zhjiehua/Network_TemperHumid/README.md

# Network_TemperHumid

网络版温湿度传感器

采集DHT12温湿度数据通过TCP/IP上传.

已实现:
  *tcp client
  *tcp server
  *udp client
  *udp server
