zhjiehua/Network_TemperHumid/PCB/HumNet.PDF

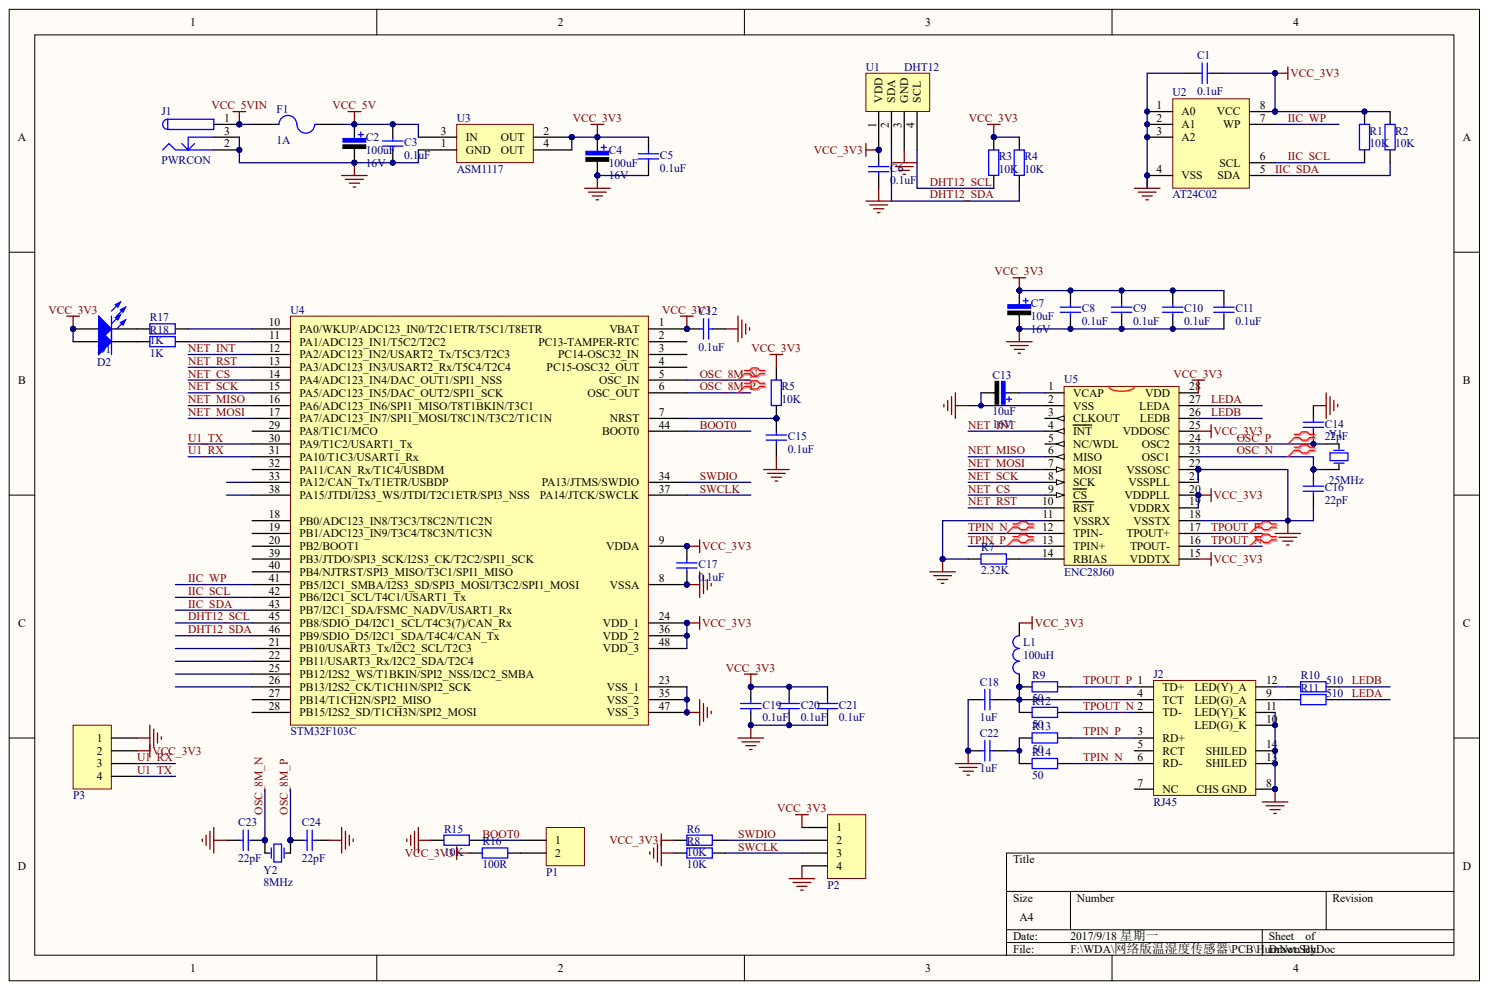
[picture p2: page 1]

U2 | 0.1uF
A0 1
A1 2 | IIC_WP

IIC_SDA

R18 | PA1/ADC123_IN1/T5C2/T2C2 11
1K | PA2/ADC123_IN2/USART2_Tx/T5C3/T2C3 12 PA3/ADC123_IN3/USART2_Rx/T5C4/T2C4 13 PA4/ADC123_IN4/DAC_OUT1/SPI1_NSS 14 PA5/ADC123_IN5/DAC_OUT2/SPI1_SCK 15 PA6/ADC123_IN6/SPI1_MISO/T8T1BKIN/T3C1 16 PA7/ADC123_IN7/SPI1_MOSI/T8C1N/T3C2/T1C1N 17 PA8/T1C1/MCO 29

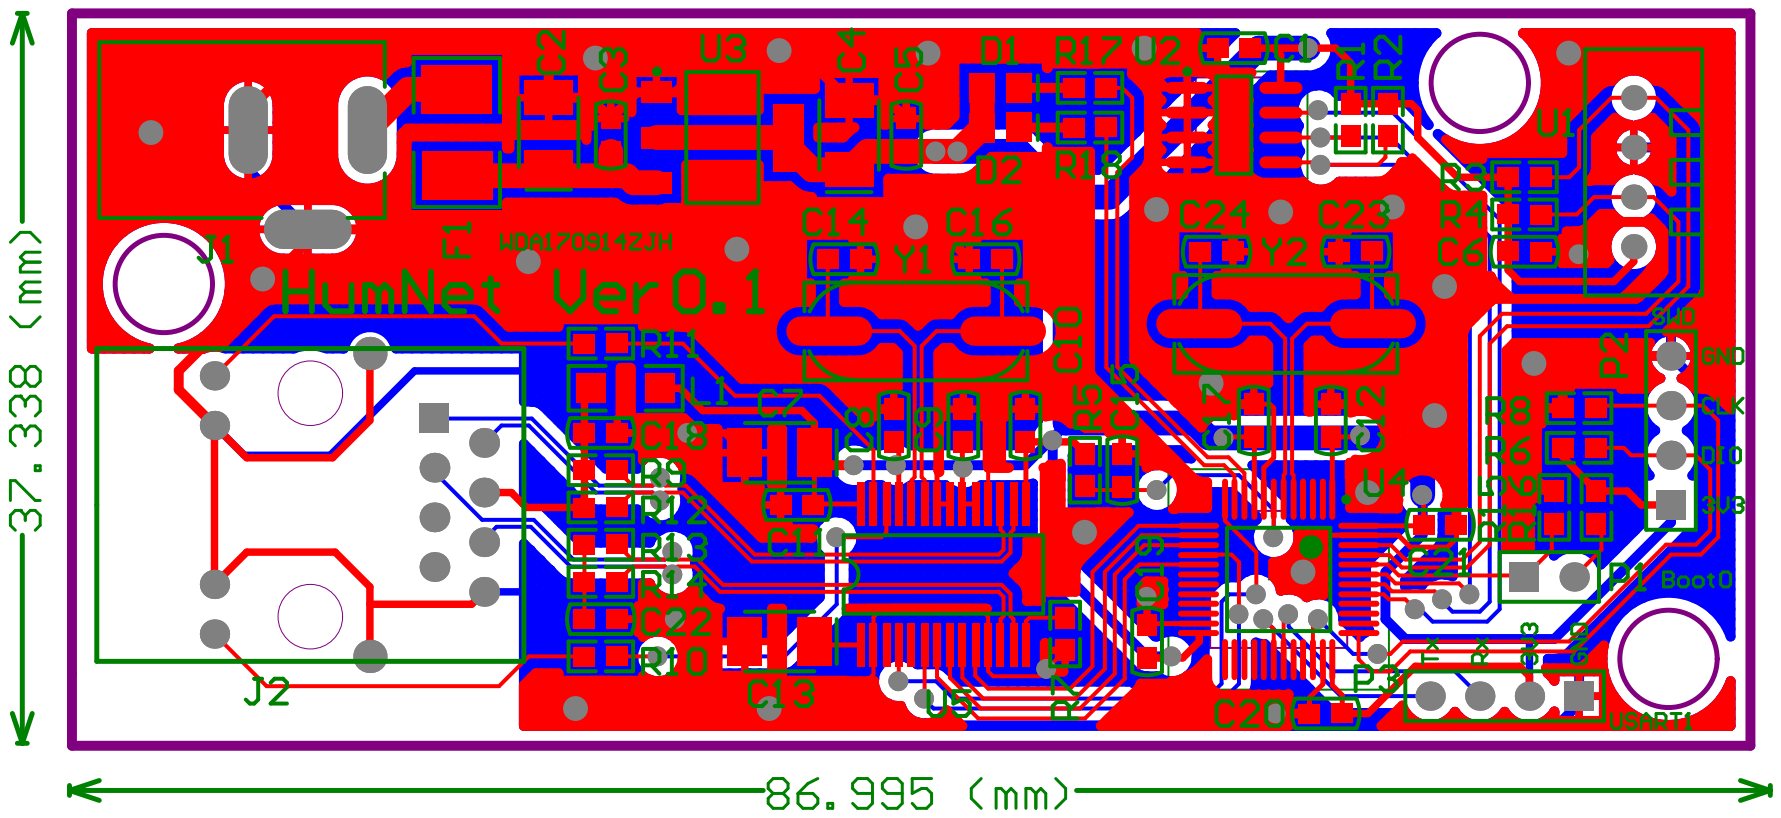
[picture p3: page 2]

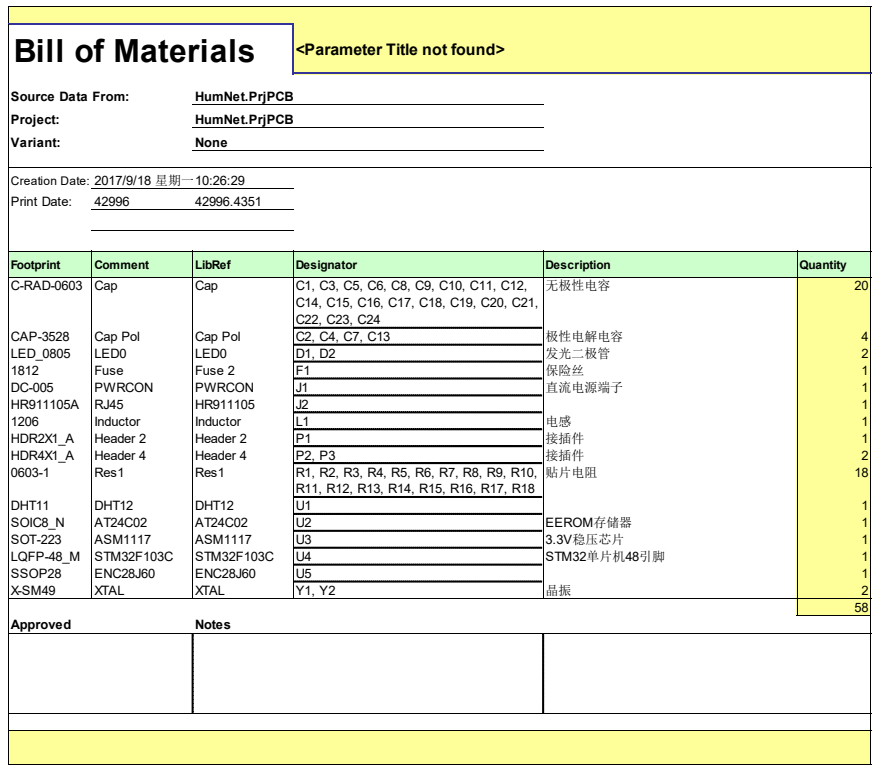
[picture p4: page 3]

Footprint | Comment | LibRef | Designator | Description | Quantity
