zhjiehua/Network_TemperHumid/(list of files, drawings)

Other design files:
PCB/HumNet.PcbDoc
PCB/HumNet.PrjPCB
PCB/HumNet.SchDoc
