zhjiehua/Network_TemperHumid/SRC/HARDWARE/24CXX/myiic.h

#ifndef __MYIIC_H
#define __MYIIC_H
#include "sys.h"
//////////////////////////////////////////////////////////////////////////////////	 
//本程序只供学习使用，未经作者许可，不得用于其它任何用途
//ALIENTEK战舰STM32开发板
//IIC驱动 代码	   
//正点原子@ALIENTEK
//技术论坛:www.openedv.com
//修改日期:2012/9/9
//版本：V1.0
//版权所有，盗版必究。
//Copyright(C) 广州市星翼电子科技有限公司 2009-2019
//All rights reserved									  
//////////////////////////////////////////////////////////////////////////////////

#define DHT12 1

#ifndef DHT12
//IO方向设置
#define SDA_IN()  {GPIOD->CRH&=0XFFFFFF0F;GPIOD->CRH|=(u32)8<<4;}
#define SDA_OUT() {GPIOD->CRH&=0XFFFFFF0F;GPIOD->CRH|=(u32)3<<4;}

//IO操作函数	 
#define IIC_SCL    PDout(10) //SCL
#define IIC_SDA    PDout(9) //SDA	 
#define READ_SDA   PDin(9)  //输入SDA 

#else

//IO方向设置
#define SDA_IN()  {GPIOB->CRH&=0XFFFFFF0F;GPIOB->CRH|=(u32)8<<4;}
#define SDA_OUT() {GPIOB->CRH&=0XFFFFFF0F;GPIOB->CRH|=(u32)3<<4;}

//IO操作函数	 
#define IIC_SCL    PBout(8) //SCL
#define IIC_SDA    PBout(9) //SDA	 
#define READ_SDA   PBin(9)  //输入SDA 
#endif

//IIC所有操作函数
void IIC_Init(void);                //初始化IIC的IO口				 
void IIC_Start(void);				//发送IIC开始信号
void IIC_Stop(void);	  			//发送IIC停止信号
void IIC_Send_Byte(u8 txd);			//IIC发送一个字节
u8 IIC_Read_Byte(unsigned char ack);//IIC读取一个字节
u8 IIC_Wait_Ack(void); 				//IIC等待ACK信号
void IIC_Ack(void);					//IIC发送ACK信号
void IIC_NAck(void);				//IIC不发送ACK信号

void IIC_Write_One_Byte(u8 daddr,u8 addr,u8 data);
u8 IIC_Read_One_Byte(u8 daddr,u8 addr);	  
#endif
