zhjiehua/Network_TemperHumid/SRC/HARDWARE/TIMER/timerx.c

#include "timerx.h"
#include "led.h"
#include "usart.h"
#include "protocol.h"
//////////////////////////////////////////////////////////////////////////////////	 
//本程序只供学习使用，未经作者许可，不得用于其它任何用途
//ALIENTEK Mini STM32开发板
//PWM  驱动代码			   
//正点原子@ALIENTEK
//技术论坛:www.openedv.com
//修改日期:2010/12/03
//版本：V1.0
//版权所有，盗版必究。
//Copyright(C) 正点原子 2009-2019
//All rights reserved
////////////////////////////////////////////////////////////////////////////////// 	  
 
u32 uip_timer=0;//uip 计时器，每10ms增加1.

//定时器6中断服务程序	 
void TIM2_IRQHandler(void)
{ 	if (TIM_GetITStatus(TIM2, TIM_IT_Update) != RESET) //检查指定的TIM中断发生与否:TIM 中断源 
	{
		uip_timer++;//uip计时器增加1
		
		htSensor.periodTimer++;
	} 
	TIM_ClearITPendingBit(TIM2, TIM_IT_Update  );  //清除TIMx的中断待处理位:TIM 中断源 
				    		  			    	    
}
 
//基本定时器6中断初始化
//这里时钟选择为APB1的2倍，而APB1为36M
//arr：自动重装值。
//psc：时钟预分频数
//这里使用的是定时器3!
void TIM2_Int_Init(u16 arr,u16 psc)		//TIM6_Int_Init(1000,719);//100Khz计数频率，计数到1000为10ms
{	
    TIM_TimeBaseInitTypeDef  TIM_TimeBaseStructure;
	NVIC_InitTypeDef NVIC_InitStructure;

	RCC_APB1PeriphClockCmd(RCC_APB1Periph_TIM2, ENABLE); //时钟使能

	TIM_TimeBaseStructure.TIM_Period = arr; //设置在下一个更新事件装入活动的自动重装载寄存器周期的值	 计数到5000为500ms
	TIM_TimeBaseStructure.TIM_Prescaler =psc; //设置用来作为TIMx时钟频率除数的预分频值  10Khz的计数频率  
	TIM_TimeBaseStructure.TIM_ClockDivision = 0; //设置时钟分割:TDTS = Tck_tim
	TIM_TimeBaseStructure.TIM_CounterMode = TIM_CounterMode_Up;  //TIM向上计数模式
	TIM_TimeBaseInit(TIM2, &TIM_TimeBaseStructure); //根据TIM_TimeBaseInitStruct中指定的参数初始化TIMx的时间基数单位
 
	TIM_ITConfig( TIM2,TIM_IT_Update|TIM_IT_Trigger,ENABLE);//使能定时器6更新触发中断
 
	TIM_Cmd(TIM2, ENABLE);  //使能TIMx外设
 	
  	NVIC_InitStructure.NVIC_IRQChannel = TIM2_IRQn;  //TIM3中断
	NVIC_InitStructure.NVIC_IRQChannelPreemptionPriority = 2;  //先占优先级0级
	NVIC_InitStructure.NVIC_IRQChannelSubPriority = 2;  //从优先级3级
	NVIC_InitStructure.NVIC_IRQChannelCmd = ENABLE; //IRQ通道被使能
	NVIC_Init(&NVIC_InitStructure);  //根据NVIC_InitStruct中指定的参数初始化外设NVIC寄存器 								 
}
