zhjiehua/Network_TemperHumid/(notices)

Notices in the files:
SRC/HARDWARE/DHT12/myiic.h:
Copyright(C) ¹ãÖÝÊÐÐÇÒíµç×Ó¿Æ¼¼ÓÐÏÞ¹«Ë¾ 2009-2019
All rights reserved
SRC/HARDWARE/TIMER/timerx.c:
Copyright(C) ÕýµãÔ­×Ó 2009-2019
SRC/HARDWARE/DM9000A/dm9k_uip.h:
Copyright (C), 2009-2010, www.armfly.com °²¸»À³µç×Ó
